Flux3tor/kaze/Images/Case-Render.jpeg

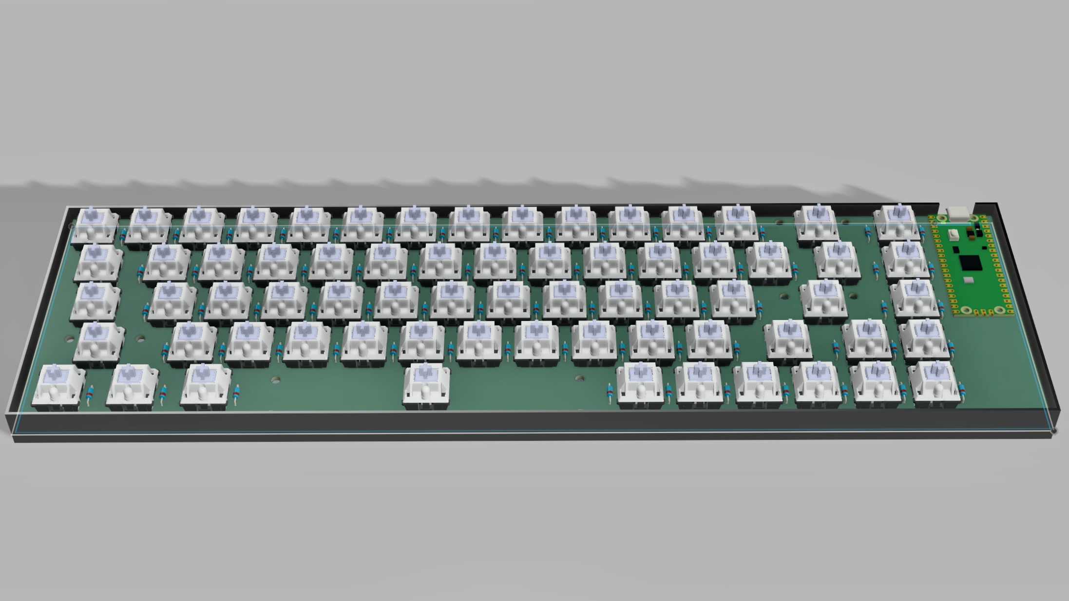
Images/Case-Render.jpeg
