Flux3tor/kaze/bom.csv

Name | Purpose | Quantity | Unit Cost (USD) | Total Cost (USD) | Distributor | Link
Akko V3 Fairy Pro Switches (Pack of 45) | Mechanical switches | 2 | 16.00 | 32.00 | StacksKB | https://stackskb.com/store/akko-fairy-pro-switch-pack-of-45/
Lakes Mountains Premium Cherry PBT Extended Keycaps | Keycaps | 1 | 29.00 | 29.00 | Curiosity Caps | https://curiositycaps.in/products/lakes-mountains-premium-cherry-pbt-extended-keycaps
Durock Clear Screw-In Stabilizers V2 | Stabilizers | 1 | 17.00 | 17.00 | StacksKB | https://stackskb.com/store/durock-clear-screw-in-stabilizers-v2/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
1N4148 Through-Hole Diodes (Pack of 10) | Matrix diodes | 7 | 0.20 | 1.40 | StacksKB | https://stackskb.com/store/1n4148-through-hole-diode/
LuatOS USB-C Raspberry Pi Pico Development Board | Main controller | 1 | 5.00 | 5.00 | MakerBazar | https://makerbazar.in/products/luatos-usb-c-raspberry-pi-pico-development-board-based-on-rp2040-microcontroller
Portronics Type-C to Type-C Cable | USB connection | 1 | 2.00 | 2.00 | Amazon | https://www.amazon.in/dp/B09Q8XMFHB?ref_=cm_sw_r_cp_ud_dp_9F8YCTNXZB2SQ3WDDXEK_1
PLA Filament | 3D-printed case | 1 | Already owned | 0.00 | NuMakers | https://india.numakers.com/products/pla-filament
PCB | Keyboard circuit board | 5 | 25 | 25 | Offline/Local Fabricator
M2 Screws | Case mounting | 6 | Already owned | 0.00 | Already owned
M2 Brass Inserts | Case mounting inserts | 6 | Already owned | 0.00 | Already owned
TOTAL |  |  |  | 112.00
