Flux3tor/kaze/CAD/kaze-assembled.step

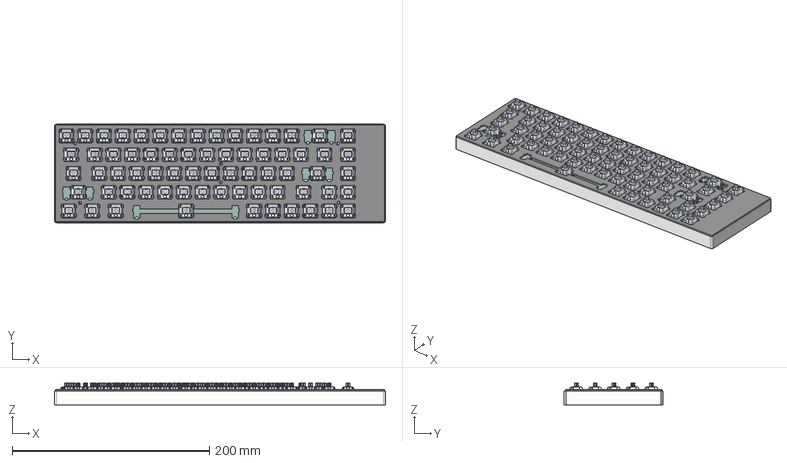
[picture p6: CAD file, 2026-10-24]
CAD/kaze-assembled.step
336.0 x 100.0 x 22.1 mm
