Flux3tor/kaze/CAD/kaze-plate.step

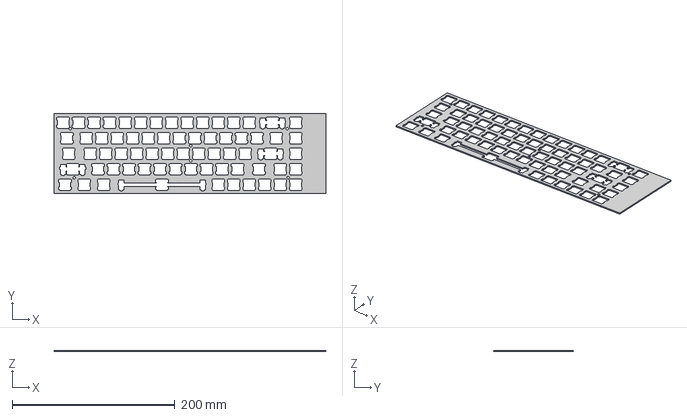
[picture p7: CAD file, 2026-10-24]
CAD/kaze-plate.step
334.0 x 98.0 x 1.50 mm
