Flux3tor/kaze/CAD/kaze.step

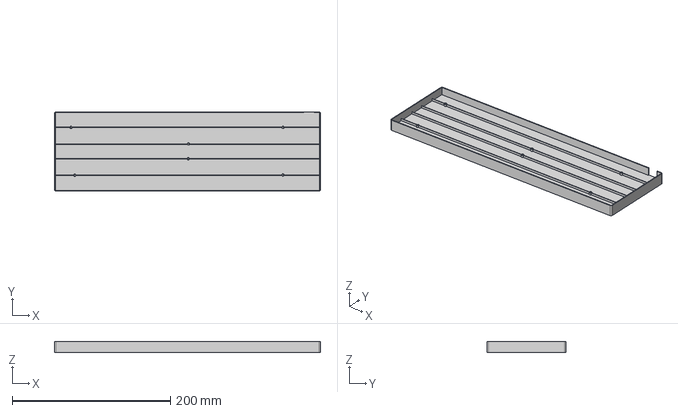
[picture p8: CAD file, 2026-10-24]
CAD/kaze.step
336.0 x 100.0 x 14.0 mm
