Flux3tor/kaze/CAD/kaze-case.step

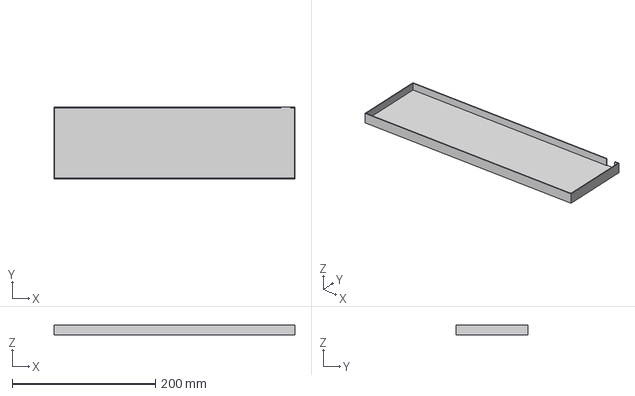
[picture p9: CAD file, 2026-10-20]
CAD/kaze-case.step
336.0 x 100.0 x 14.0 mm
