Flux3tor/kaze/(list of files, cad)

Other CAD files:
CAD/kaze-assembled-source.f3z
CAD/kaze-assembled.f3z
CAD/kaze-plate.f3d
CAD/kaze.f3d
