Flux3tor/kaze/kaze.pdf

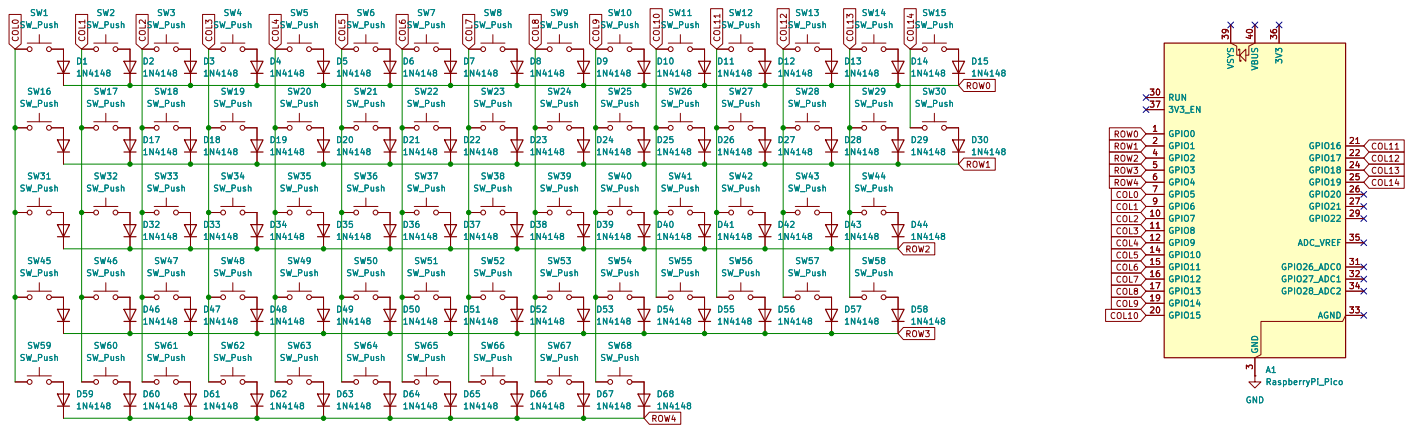
[picture p10: page 1]

SW17 | 1N4148 D3 | SW_Push 1N4148 D46 1N4148 D46 SW19 SW19 | D49 1N4148 D2 | | SW_Push SW21 SW22 SW22 | SW_Push SW23 SW23 | SW24 | | SW_Push SW26 SW26 | 1N4148 D27 SW_Push SW16 SW_Push SW21 SW27 SW27 | SW28 SW28 SW_Push SW48

SW33 | SW34 | SW35 SW_Push SW59 | SW36 | 1N4148 1N4148 D37 SW_Push SW31 SW37 | D23 1N4148 1N4148 D37 SW38 | SW39 | 1N4148 D24 1N4148 D38 SW40 SW40 | D25 1N4148 D39 | SW_Push SW38 | 1N4148 D26 SW_Push SW42 SW_Push SW42 SW43 SW43 | 1N4148 D28 1N4148 D32 SW44 SW44 SW_Push

SW_Push SW45 SW_Push SW45 SW46 SW46 | | SW_Push SW47 SW47 | | SW48 | 1N4148 D34 | SW49 | | SW50 | | 1N4148 D35 SW51 | | SW_Push | SW53 | SW_Push SW53

Size: A3 | Rev: | F Date:
KiCad E.D.A. 10.0.6 | Id: 1/1
