Flux3tor/kaze/kaze-schem.pdf

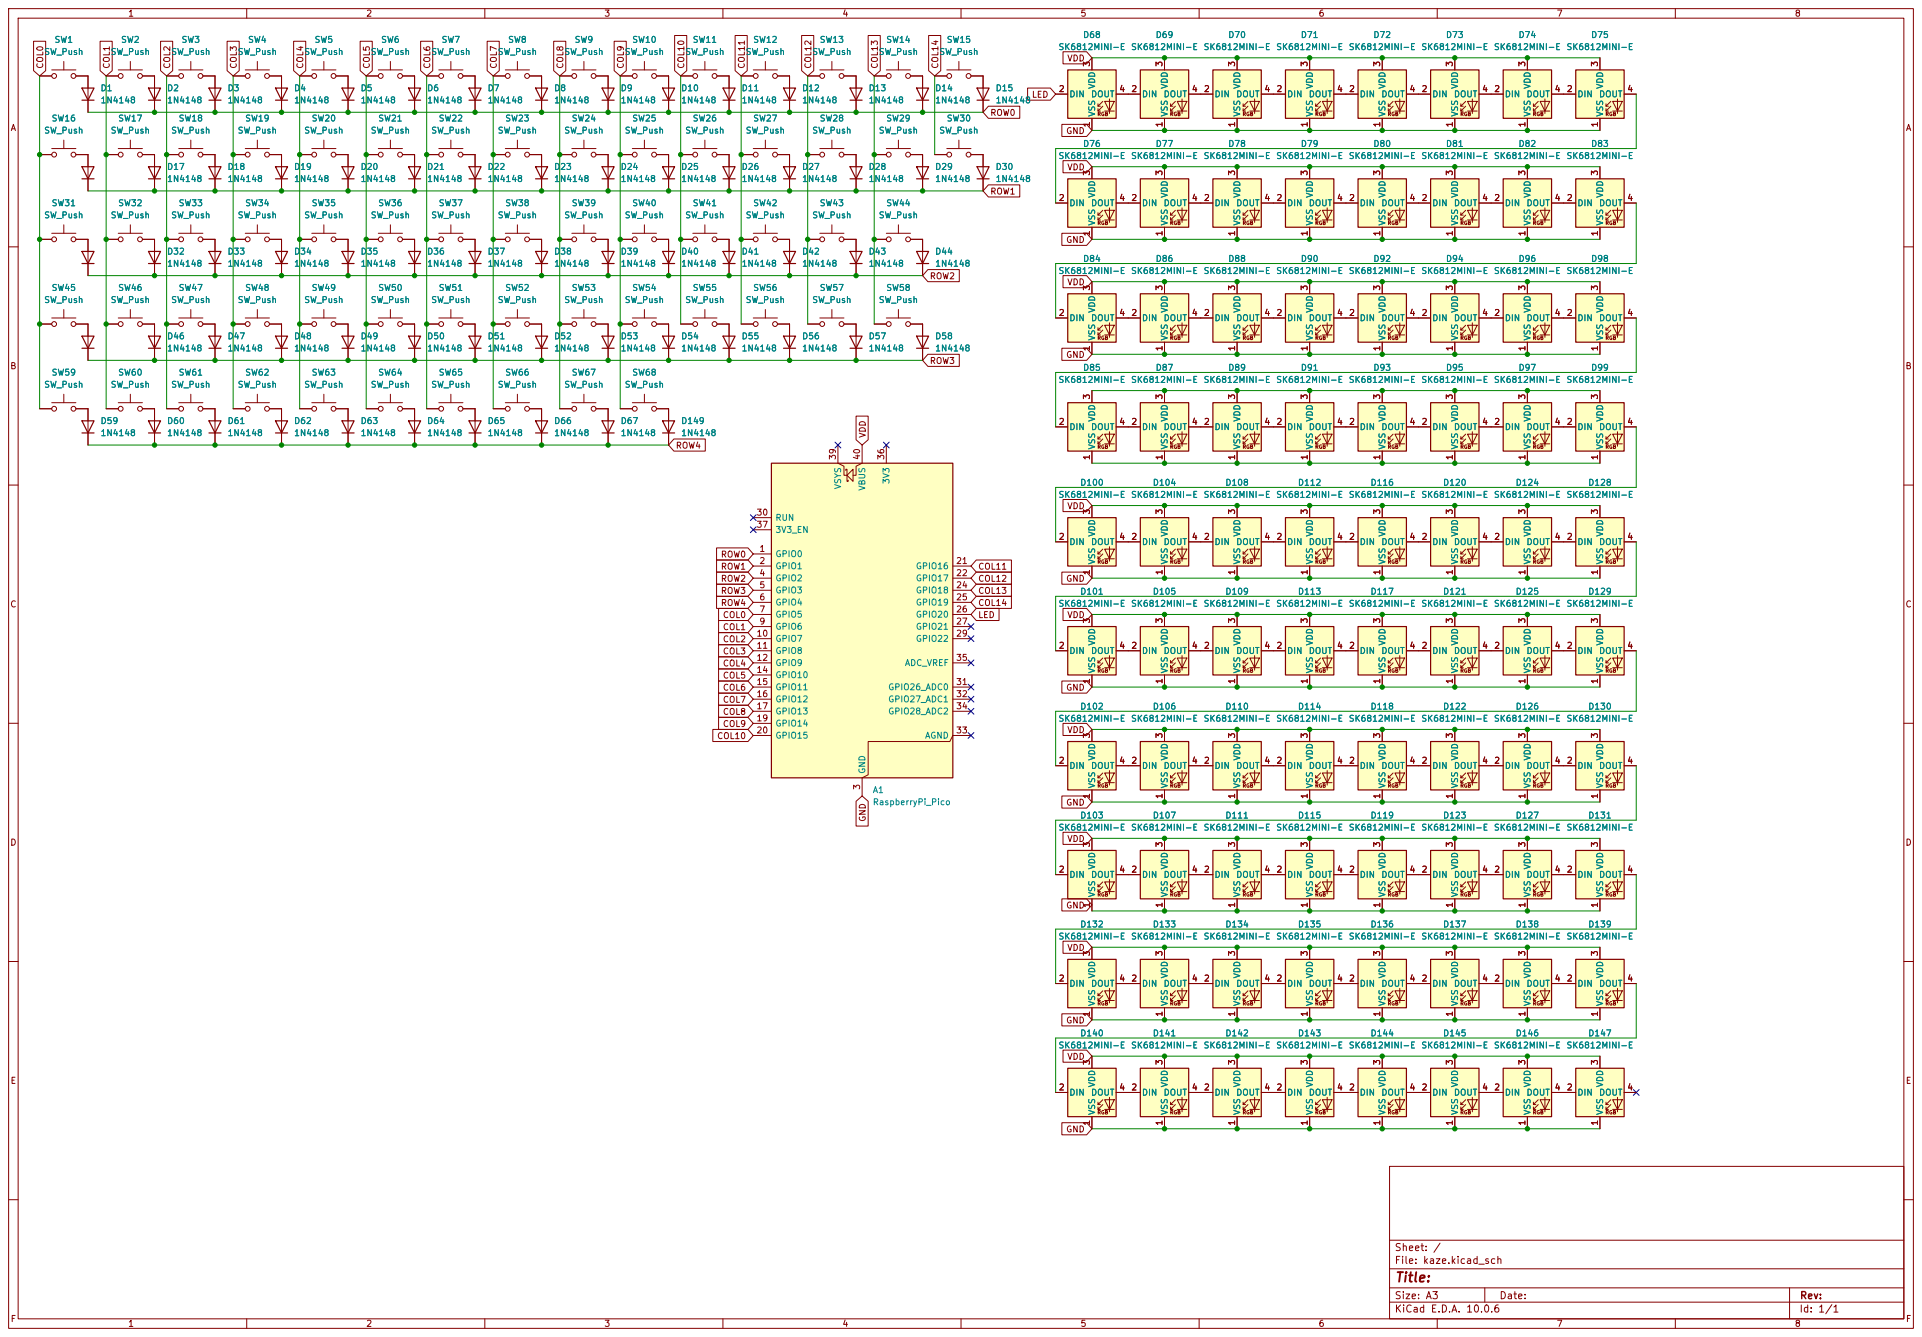
[picture p11: page 1]

SW_Push SW17 | SW18 | SW19 | D5 SW20 | SW_Push SW59 SW21 | SW22 | SW_Push D38 SW23 SW23 | SW_Push SW24 | SW_Push D39 SW_Push SW24 SW25 SW25 | SW26 | SW_Push D11 1N4148 D27 SW27 SW27 | SW28

SW_Push | | SW_Push SW32 SW33 SW33 | | SW_Push SW31 SW34 | | SW35 | | SW36 | | SW37 | | SW38 | SW_Push SW39 | SW_Push SW39 SW40 | SW41 | SW42 | SW43 | SW_Push SW43

Size: A3 | Rev:
KiCad E.D.A. 10.0.6 | Id: 1/1
