Flux3tor/kaze/(commit log)

2026-10-08 new journal + files!
    [kaze.kicad_pcb, kaze.kicad_sch]
2026-10-20 add bom
2026-10-22 update BOM
